steveboyer/Senior-Design-Report/child-packaging.png

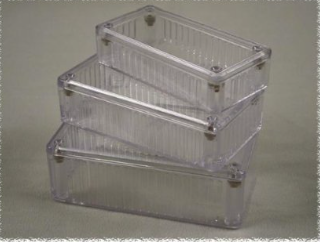
child-packaging.png
