steveboyer/Senior-Design-Report/hub-packaging.png

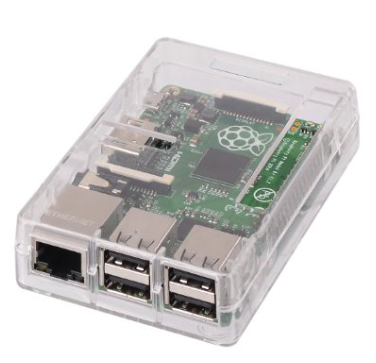
hub-packaging.png
