steveboyer/Senior-Design-Report/AD-gpio-eps-converted-to.pdf

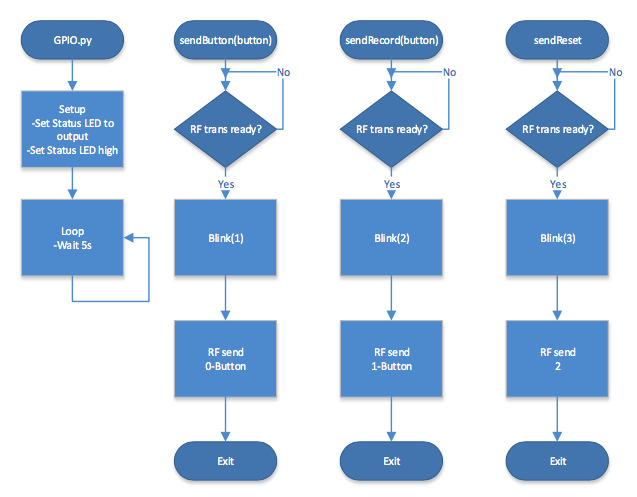
[picture p13: page 1]
