steveboyer/Senior-Design-Report/CKT-hub-eps-converted-to.pdf

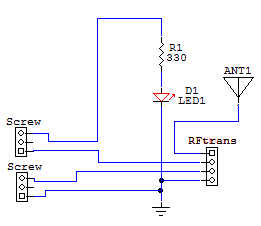
[picture p14: page 1]
