steveboyer/Senior-Design-Report/final-eps-converted-to.pdf

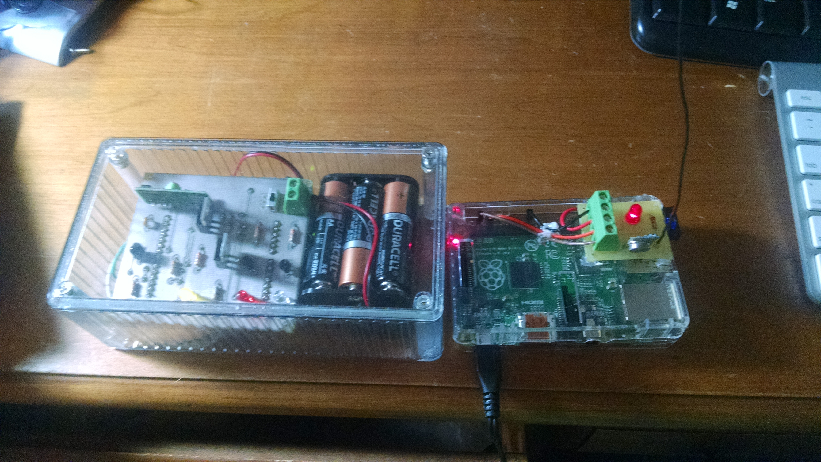
[picture p15: page 1]
