steveboyer/Senior-Design-Report/schedule-eps-converted-to.pdf

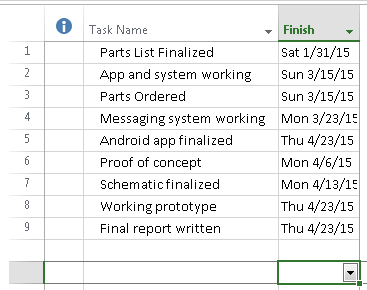
[picture p16: page 1]
