steveboyer/Senior-Design-Report/SD-gpio-eps-converted-to.pdf

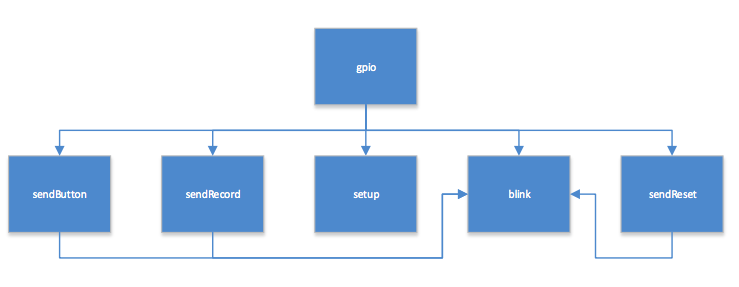
[picture p17: page 1]
