steveboyer/Senior-Design-Report/SD-SDR-eps-converted-to.pdf

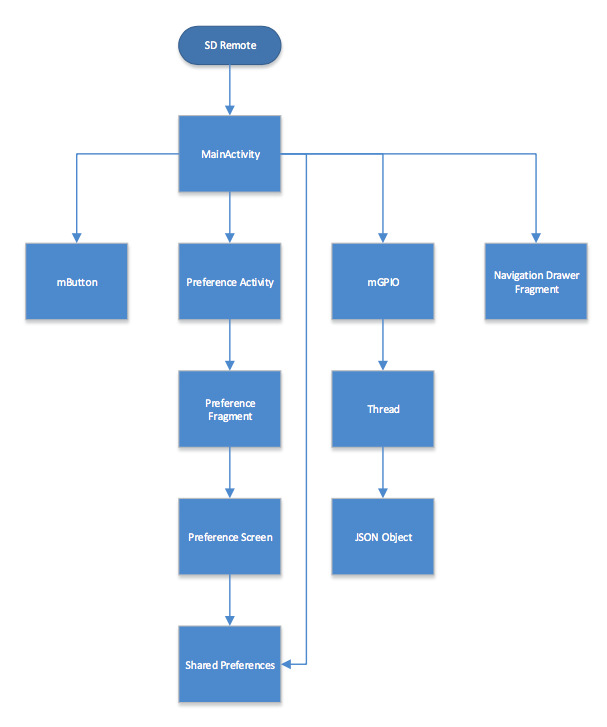
[picture p18: page 1]
