steveboyer/Senior-Design-Report/AD-Blink.png

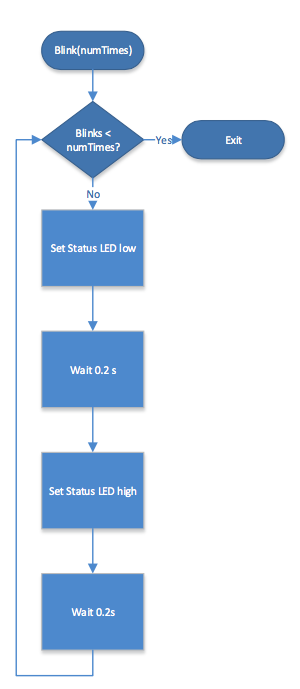
AD-Blink.png
