steveboyer/Senior-Design-Report/parts.tex

% Table generated by Excel2LaTeX from sheet 'Sheet1'
\begin{table}[htbp]
  \centering
  \caption{Add caption}
    \begin{tabular}{rrrrr}
    \toprule
    Part  & Source & Unit Cost & Number  & Total \\
    \midrule
    Raspberry Pi & Newark.com & \$40.00 & 1     & \$40.00 \\
    Arduino Uno & Sparkfun.com & \$29.95 & 1     & \$29.95 \\
    Child Case & Amazon.com & \$13.71 & 1     & \$13.71 \\
    USB Wifi Adapter & Amazon.com & \$8.99 & 1     & \$8.99 \\
    Hub Case & Amazon.com & \$8.99 & 1     & \$8.99 \\
    Power Cord & Amazon.com & \$5.99 & 1     & \$5.99 \\
    Battery Case & Amazon.com & \$5.70 & 1     & \$5.70 \\
    RF Rec & Sparkfun.com & \$4.95 & 1     & \$4.95 \\
    RF Trans & Sparkfun.com & \$3.95 & 1     & \$3.95 \\
    IR Rec & Sparkfun.com & \$1.95 & 1     & \$1.95 \\
    Battery Clip & Amazon.com & \$1.58 & 1     & \$1.58 \\
    IR LED & Sparkfun.com & \$0.95 & 1     & \$0.95 \\
    Switch & Amazon.com & \$0.75 & 1     & \$0.75 \\
    AA Battery & Amazon.com & \$0.43 & 6     & \$2.59 \\
    2N3904 & Mouser.com & \$0.41 & 2     & \$0.82 \\
    Red LED & Sparkfun.com & \$0.35 & 2     & \$0.70 \\
    Yellow LED & Sparkfun.com & \$0.35 & 1     & \$0.35 \\
    1 Mohm resistor & Radioshack & \$0.25 & 1     & \$0.25 \\
    0.1 uF cap & Sparkfun.com & \$0.25 & 1     & \$0.25 \\
    Screw terminal & Amazon.com & \$0.21 & 3     & \$0.62 \\
    Voltage Regulator & Sparkfun.com & \$0.95 & 2     & \$1.90 \\
    330 ohm resistor & Mouser.com & \$0.10 & 5     & \$0.50 \\
    Grand total &       &       &       & \$135.43 \\
    \bottomrule
    \end{tabular}%
  \label{tab:addlabel}%
\end{table}%
