steveboyer/Senior-Design-Report/PartsList (2).xlsx

Name | Web Address | Price | Quantity | Total
IR Receiver Diode | https://www.sparkfun.com/products/10266 | $1.95 | 2 | $3.90
Raspberry Pi | http://www.newark.com/raspberry-pi/raspberry-modb-8gb-usd/raspberry-pi-model-b-8gb-noobs/dp/68X0156 | $40.00 | 1 | $40.00
IR LED | https://www.sparkfun.com/products/9349 | $0.95 | 2 | $1.90
56 Ohm Resistor | http://www.mouser.com/ProductDetail/Xicon/291-56-RC/?qs=sGAEpiMZZMtlubZbdhIBIKlFPb6t720RQDIcNWy2MBw%3d | $0.10 | 2 | $0.20
330 Ohm Resistor | http://www.mouser.com/ProductDetail/KOA-Speer/MF1-4DCT52R3300F/ | $0.10 | 4 | $0.40
2N3904 Transistor | http://www.mouser.com/ProductDetail/Central-Semiconductor/2N3904/ | $0.41 | 2 | $0.82
0.15 uF capacitor | http://www.newark.com/kemet/c320c154k5r5ta/cap-mlcc-x7r-150nf-50v-rad/dp/72K8267 | $0.57 | 2 | $1.15
