steveboyer/Senior-Design-Report/(list of files, drawings)

Other design files:
uno3.PCB
vic-uno3-b-nko.PCB
